fotherja/EV_Charger/README.md

# EV_Charger
Arduino Uno Code for EV Charger together with the design files etc

This project is documented in detail here: https://jamesfotherby.com/index-page/electric-vehicle-charger/
