fotherja/EV_Charger/EV Charger BOM.xlsx

EV Charger BOM
Description | Supplier | Part number | cost
Zappi Enclosure | 2nd hand off eBay... |  | £120
6mm2 SWA 5m length | https://quickbit.co.uk/ |  | £17.34
SWA Cable Gland Pack - CW20 Outdoor | https://quickbit.co.uk/swa-gland-pack-cw20/ |  | £5.34
SW Cleats | https://quickbit.co.uk/ |  | £1.99
50A MCB | Screwfix |  | £3.68
SMPS 340mA +/-15V | https://www.mouser.co.uk/ProductDetail/RECOM-Power/RAC10-15DK-277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 | RAC10-15DK/277 | £11.85
2 x 40A 250V relays | https://www.mouser.co.uk/ProductDetail/TE-Connectivity-PB/T9VV1K15-12S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 | T9VV1K15-12S | £18
LM317 | https://www.mouser.co.uk/ProductDetail/onsemi/lm317tg/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 | LM317TG | £0.67
LM337 | https://www.mouser.co.uk/ProductDetail/onsemi/lm337btg/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 | LM337BTG | £0.68
TVS 13.6V 600W bidirectional | https://www.mouser.co.uk/ProductDetail/Littelfuse/P6KE16CA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 | P6KE16CA | £0.35
Arduino Pro-Mini | https://www.amazon.co.uk/gp/product/B07VKLFYHY/ref=ppx_yo_dt_b_asin_title_o03_s00?ie=UTF8&psc=1 | . | £5.50
OP07 | https://www.mouser.co.uk/ProductDetail/Analog-Devices/OP07CPZ?qs=WIvQP4zGaninz564Y%252B7wyA%3D%3D | OP07CPZ | £2.25
LM358
GFCI Transformer with self test | https://shop.openenergymonitor.com/gfci-for-openevse/ | . | £32
All the other parts are more or less off the shelf...
