fotherja/EV_Charger/(threads)

Thread 1 (2022-04-29):

Not yet open source

MrTechGadget, 2022-04-29:
Can you select a license if you are intending this to be open source? Without a license, we can't use your materials even for private use or contribute to it.

Thanks, it looks great!

https://docs.github.com/en/repositories/managing-your-repositorys-settings-and-features/customizing-your-repository/licensing-a-repository

fotherja, 2022-04-29:
I have added an MIT license.txt file. Is that now ok or does that not work for the non-software files?

MrTechGadget, 2022-04-30:
Works perfectly and covers the Arduino code as well, thanks again for sharing this solution, I look forward to tinkering with my own!

Closed 2022-04-30.

Thread 2 (2022-05-17):

ADC operation

bosston88, 2022-05-17:
First, thanks for your work and for sharing it! I was looking at the code and found something I would like to understand better. Is ADC working in the way, that it reads Pilot voltage once and then GFCI value for 255 times? Then "selector" overflows and repeats?
`// This code runs when the PWM signal is in the middle of its low period
ISR(TIMER1_OVF_vect)
{
  static byte selector = 0;
  if(ADCSRA & 0b01000000)                                                       // If the ADC is still performing a conversion (it shouldn't be) then return
    return;

  if(selector && 1)  {
    ADMUX = B01000000;
    ADCSRA |= B01000000;
    ADC_Channel = 0;
  }
  else  {
    ADMUX = B01000001;
    ADCSRA |= B01000000;
    ADC_Channel = 1;
  }

  selector++;
}`
I think it violates the standard where you need to "react" to any change from state C within 100ms. Correct me if I'm wrong.

fotherja, 2022-05-17:
Hello,
Thanks for pointing this out. What I meant to do was a bitwise & so that as the selector variable increments it alternately reads the GFCI ADC channel and then the Pilot voltage before repeating

I suppose I never noticed because 255ms is still pretty quick. I will correct this.

bosston88, 2022-05-18:
Glad I could help. This could work:
`ISR(TIMER1_OVF_vect)
{
static byte selector = 0;
if(ADCSRA & 0b01000000) // If the ADC is still performing a conversion (it shouldn't be) then return
return;

if(selector) {
ADMUX = B01000000;
ADCSRA |= B01000000;
ADC_Channel = 0;
selector = 0;
}
else {
ADMUX = B01000001;
ADCSRA |= B01000000;
ADC_Channel = 1;
selector = 1;
}
}`

fotherja, 2022-05-22:
I have now corrected this and tested the new code. Up and running and working. Thank you very much!

Closed 2022-05-22.

Thread 3 (2023-03-22):

Cannot get car to charge

m1geo, 2023-03-22:
Hi.

I have copied your circuit part-for-part on your PCB and am having a few issues. Using resistors and a diode on the CP line, I can toggle between state A and state B, but cannot get into state C where charging begins.

If I connect my car (Tesla Model Y Perf) the car requests charging but the contactors never click. The car stops with "Ready to charge, waiting for charger power". The charger UART shows State A going into State B and stopping.

Just wondered where I should look first.

Thanks!

fotherja, 2023-03-23:
Sounds like the Arduino is not reading the pilot voltages correctly or the pilot voltages are not in spec.

If it moves from state A to state B then it must be reading the pilot voltage to some extent. Perhaps your resistor values aren't quite right?

I'd advise outputting the ADC readings over serial so that you can see whether they are appropriate. Let me know how it goes out of you have any other questions

m1geo, 2023-03-23:
Thanks. I thought as much. I'll tinker with the ADC threshold values - I saw your code for printing out the ADC values. Using that causes the Arduino to reboot, so I added a call to reset the WDT into the loop.

**Do you know what test resistor values I should be using to switch between each state?**

I'm using a simple 1N4148 in series with fixed through-hole resistors to simulate the car while testing. I see the same situation when using fixed resistors; State A > State B, but never any further. The Arduino ignores my attempt for a transition between State B onwards. Messing with the value too much results in a fault (understandable) but I cannot get things to work as I had hoped. I'm pretty sure I have used the correct resistors.

fotherja, 2023-03-23:
Good stuff re. Adding WDT reset into the loop.

In order to proceed from state B to state C the GFCI test needs to be successful. Is that holding things up?

A 900 ohm resistor and diode to ground should be about right.

m1geo, 2023-03-23:
Great, thanks. No, I have the RCD (GFCI) test working OK using a cheap transformer. I added 5 turns of wire to it to inject a fault current. Passes the test in around ~20ms (from my memory).

Nice project. Thanks.

Thread 5 (2023-03-24):

Adaption to 3-phase

m1geo, 2023-03-24:
Hi James.

Do you know what changes if I wish to make a 3-phase variant of this? My understanding is that I just provision 2 more relays and adjust the GFCI to monitor all phases?

Is the protocol is the same, with the PWM indicating the current per phase?

fotherja, 2023-03-27:
I'd only be guessing I'm afraid.

Closed 2023-03-27.

Thread 6 (2023-09-23):

Still working?

opb, 2023-09-23:
Hi James. I’ve been eying up your project for a while and even got some PCBs printed. I just wanted to double check that it’s all working as expected a year or more after it looks like this was completed. Any additional thoughts since the project was last updated?

Cheers,
Olly

fotherja, 2023-09-23:
Hi Olly,
I've been using the charger a few times a week since this repo was created. It's worked flawlessly. I think the last time I opened up the enclosure was over a year ago and that was to add the watch dog timer and fix a software bug that was identified early on. But the code here has those updates.

I've never hankered after any smart features because I can set charge times using my car's phone app and my electricity is monitored by my smart meter anyway.

I can't say that all my projects have proven to be as reliable as this one. It worked through last year's scorching summer and this winters -10oC nights. So I'm genuinely very pleased with it.

I have noticed on the pilot pin of the charging plug a very small amount of blue (I guess copper) corrosion. It's barely noticeable even after a year and I don't think it'll ever cause a problem. plugging/unplugging keeps the contacts clean. I was wondering if this could be because 12v DC is on the pilot pin continuously. I'm not going to do anything about it - since I noticed it I always hang the charging plug down so water will never pool inside the plug (it's all outside). If I had to think of an improvement on this project I'd look into making (hardware and software changes) so that in the idle state, the hardware only occasionally applies 12v to the pilot pin to see whether a car is connected and if not keeps the pilot pin at 0v. If that makes sense?

opb, 2023-09-23:
Hi James

Thanks for the response. Great to hear it’s still working flawlessly! I was contemplating making a a couple of adjustments to get a networked Arduino in there, and have it communicate state or error state to Home Assistant. However, I have a networked 40A relay with power monitoring that I’ll put into the enclosure for turning overall power on or off. I think trying to modify the code and PCB would just mean I’ll never get it completed!

Plus, if there is an issue with the 12v pulse running constantly, hopefully that would be resolved with the ability to turn on and off to a schedule with Home Assistant. Sadly my car has no app or any smart features.

Last question, sorry - how does the PWM value of 350 translate to the 30-32A needed for the 7.4kW you mention in the code comments? The linked docs in your PDF indicate a 50-55% duty cycle for this current, so I’m keen to understand how the value in the code maps to the percentage. If you have any insight, it would be much appreciated!

Thanks

fotherja, 2023-09-25:
Hi Olly,
Regarding the PWM value of 350. Good point. This was trial and error for me. I tried a few values and this resulted in a 7.4kW charge rate. Can't really say how it translates although when I scoped the PWM signal being generated there is quite a noticeable skew rate from the op-amp output. Perhaps this is why it doesn't translate accurately. A faster op-amp might help this. I've never charged any other car than my Kia ENiro so I don't know if different cars would read the PWM signal differently because of the slew and charge at slightly different rates.

opb, 2023-10-10:
Hi James. I'll close this issue. I now have a fully built PCB and am looking forward to final assembly. I do have one question, which I'll open as a separate issue.

Thanks again for your work on this project!

Closed 2023-10-10.

Thread 7 (2023-10-07):

Discussion: a tutorial maybe?

vahidreza, 2023-10-07:
hi @fotherja,
great experiment btw, i happen to do the same thing with pico as a trial to see if i can make my own complete product out of it.
do you consider putting up a course about it? maybe on udemy or similar? that would be a killer i think and im gonna buy right in to it! :)

fotherja, 2023-10-11:
It's a good idea. I have documented the build fairly thoroughly on my website (https://jamesfotherby.com/index-page/electric-vehicle-charger/)

I could make a full course - although I don't know how responsible this would be of me. This project doesn't comply with the stringent safety requirements of modern EV chargers (Type B RCD functionality etc). People need to build this at their own risk and take responsibility of its safety themselves - I don't want to take on any of that responsibility!

Thread 8 (2023-10-10):

GFCI test successful with no hardware

opb, 2023-10-10:
Hi James

I've flashed the pro mini and with no other hardware connected, just the mini connected via the serial-USB dongle, I get the following on the serial monitor:

```Ground fault detection time: 19 ms
GFCI Test Successful
Starting in State A
FAULT: 5```

I guess fault `5` is to be expected - no pilot voltage, but I wouldn't have expected it to pass the GFCI test. Would you expect it to do this if detached from the board?

Thanks

fotherja, 2023-10-10:
Hi,
Interesting. Without the current transformer attached the GFCI test should not pass. I suspect a hardware problem. Can you use a multimeter to measure the voltage on A0 which is the processed GFCI signal. It should be 0v. Are you happy with the op-amps and their connections etc?

fotherja, 2023-10-11:
Also, you shouldn't be getting a fault 5 code. I suspect you're getting this code because the pilot should be DC +12v but this isn't being produced accurately enough by the op-amps.

The op-amps can't necessarily swing their outputs to their supply rails. As such they need suppling with a slightly higher voltage than what you want them to produce. I think my power rails are +/- 13.5V. Use a multimeter to measure your +12V DC pilot signal and adjust your +ve power supply voltage until you get this. (I'd then set the -ve rail voltage to be equal in magnitude to the +ve rail)
