fotherja/EV_Charger/KiCad_Files/EV_Charger2.kicad_pcb

## KiCad design KiCad_Files/EV_Charger2.kicad_pcb (2022-04-20)

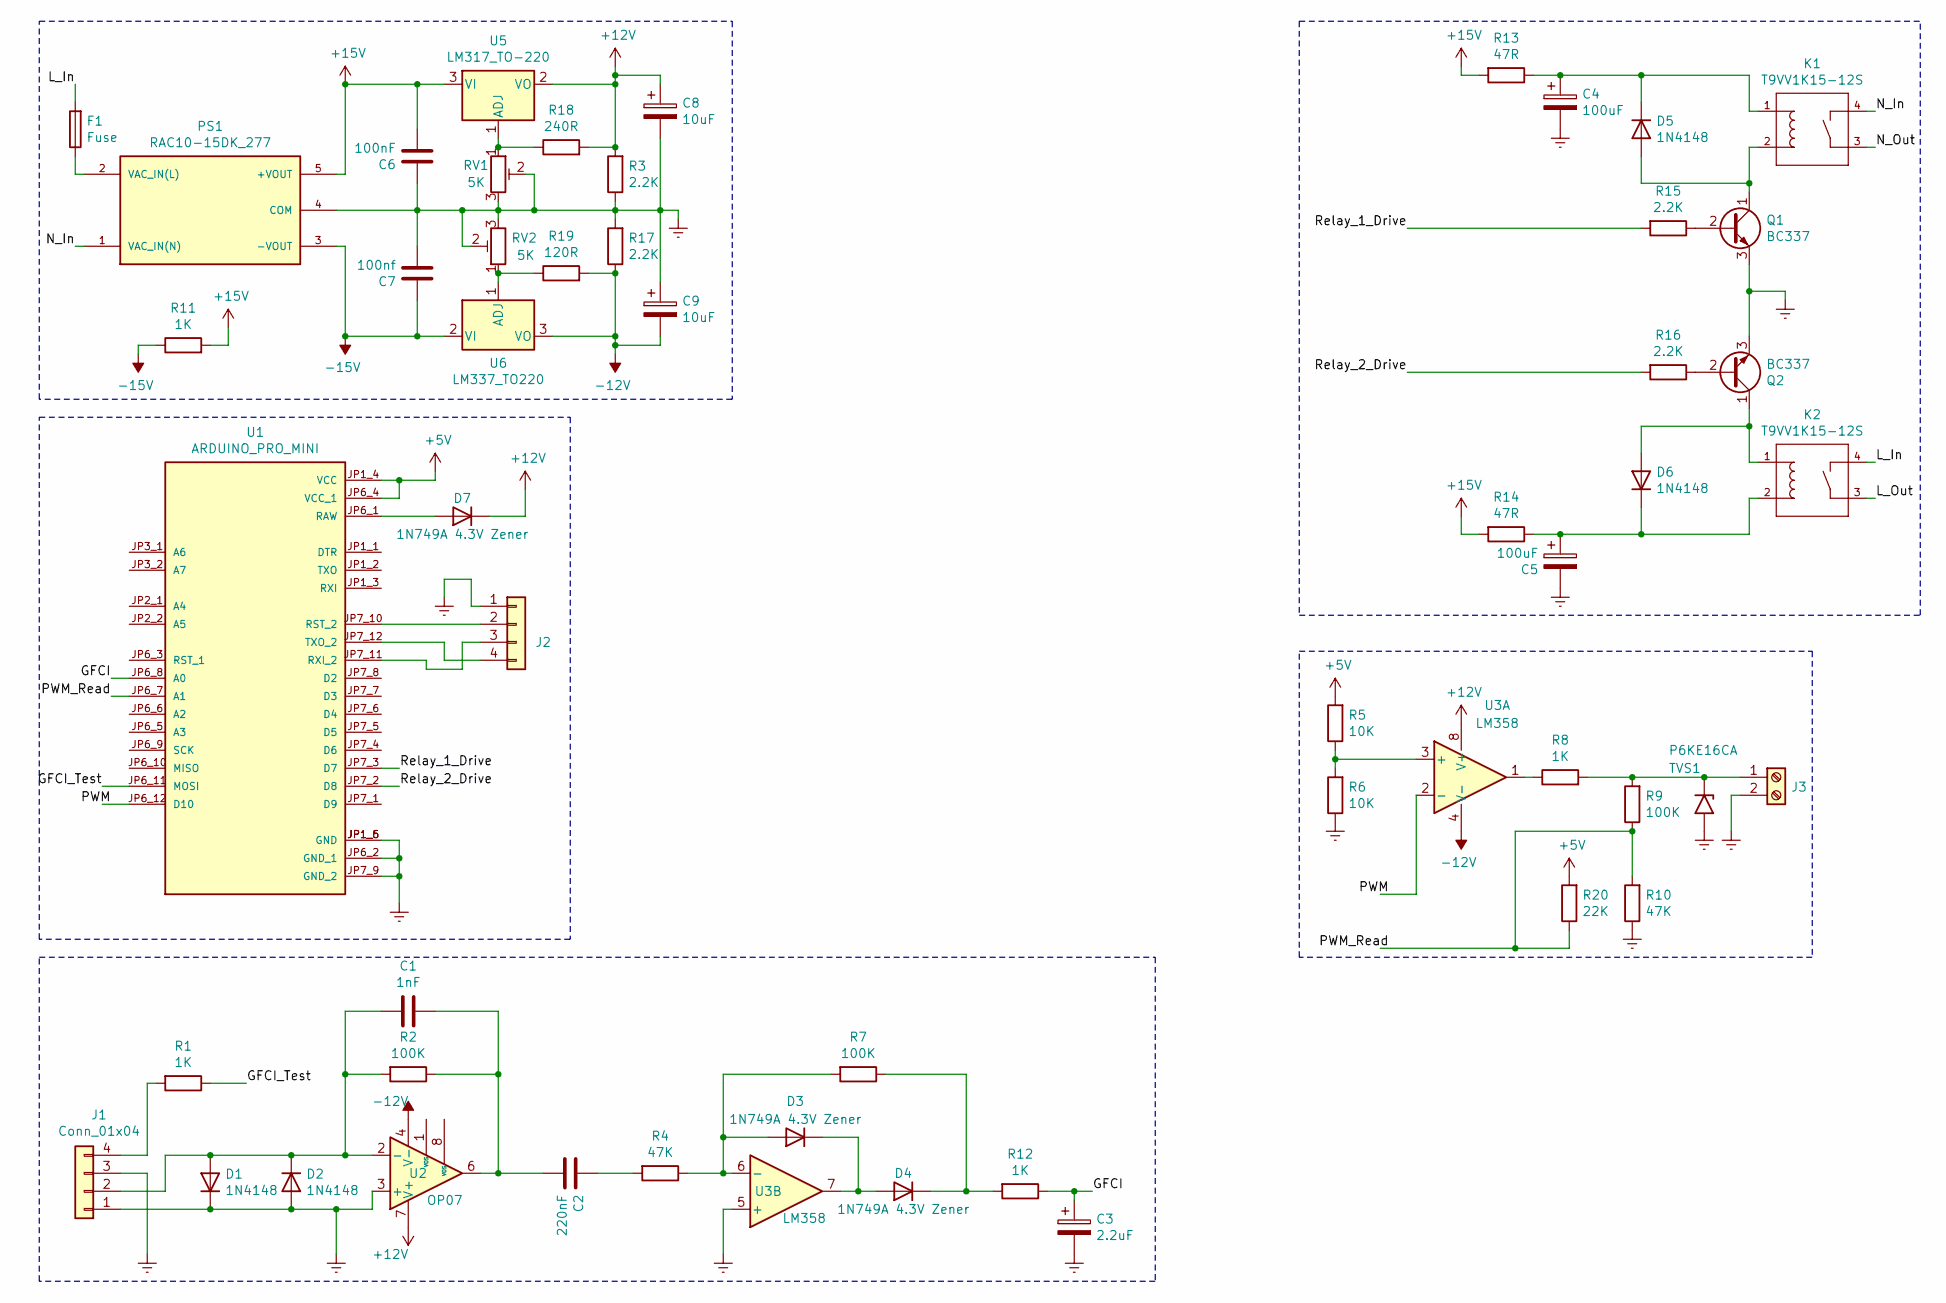
[picture p15: schematic EV_Charger2.sch, EV Charger Schematic]

Parts:
C1: 1nF; C_Disc_D3.4mm_W2.1mm_P2.50mm
C2: 220nF; C_Disc_D3.4mm_W2.1mm_P2.50mm
C3: 2.2uF; CP_Radial_D4.0mm_P1.50mm
C4, C5: 100uF; CP_Radial_D5.0mm_P2.50mm
C6: 100nF; C_Disc_D3.4mm_W2.1mm_P2.50mm
C7: 100nf; C_Disc_D3.4mm_W2.1mm_P2.50mm
C8, C9: 10uF; CP_Radial_D5.0mm_P2.50mm
D1, D2, D5, D6: 1N4148; D_DO-35_SOD27_P7.62mm_Horizontal
D3, D4, D7: 1N749A 4.3V Zener; D_DO-35_SOD27_P7.62mm_Horizontal
F1: Fuse; Fuseholder5x20_horiz_open_lateral_Type-II
J1, J2: Conn_01x04; Pin_Header_Straight_1x04_Pitch2.54mm
J3: Screw_Terminal_01x02; Socket_Strip_Straight_1x02_Pitch2.54mm
K1, K2: T9VV1K15-12S; RELAY_T9VV1K15-12S
PS1: RAC10-15DK_277; CONV_RAC10-15DK_277; PARTREV 8/2020
Q1, Q2: BC337; TO-92_Molded_Narrow
R1, R8, R12: 1K; R_Axial_DIN0207_L6.3mm_D2.5mm_P10.16mm_Horizontal
R2, R7, R9: 100K; R_Axial_DIN0207_L6.3mm_D2.5mm_P10.16mm_Horizontal
R3, R15, R16, R17: 2.2K; R_Axial_DIN0207_L6.3mm_D2.5mm_P10.16mm_Horizontal
R4, R10: 47K; R_Axial_DIN0207_L6.3mm_D2.5mm_P10.16mm_Horizontal
R5, R6: 10K; R_Axial_DIN0207_L6.3mm_D2.5mm_P10.16mm_Horizontal
R11: 1K; R_Axial_DIN0309_L9.0mm_D3.2mm_P15.24mm_Horizontal
R13, R14: 47R; R_Axial_DIN0309_L9.0mm_D3.2mm_P15.24mm_Horizontal
R18: 240R; R_Axial_DIN0207_L6.3mm_D2.5mm_P10.16mm_Horizontal
R19: 120R; R_Axial_DIN0207_L6.3mm_D2.5mm_P10.16mm_Horizontal
R20: 22K; R_Axial_DIN0207_L6.3mm_D2.5mm_P10.16mm_Horizontal
RV1, RV2: 5K; Potentiometer_Trimmer_Bourns_PV36W
TVS1: P6KE16CA; D_DO-35_SOD27_P10.16mm_Horizontal
U1: ARDUINO_PRO_MINI; MODULE_ARDUINO_PRO_MINI; PARTREV N/A
U2: OP07; DIP-8_W7.62mm
U3: LM358; DIP794W45P254L959H508Q8
U5: LM317_TO-220; TO-220-3_Vertical
U6: LM337_TO220; TO-220-3_Vertical

Connections:
+5V: R5.2, R20.2, U1.JP1_4 (VCC), U1.JP6_4 (VCC_1)
+12V: C8.1, D7.1 (K), R3.2, R18.2, U2.7 (V+), U3.8 (V+), U5.2 (VO)
+15V: C6.2, PS1.5 (+VOUT), R11.2, R13.2, R14.2, U5.3 (VI)
-12V: C9.2, R17.1, R19.2, U2.4 (V-), U3.4 (V-), U6.3 (VO)
-15V: C7.1, PS1.3 (-VOUT), R11.1, U6.2 (VI)
/GFCI: C3.1, R12.1, U1.JP6_8 (A0)
/GFCI_Test: R1.1, U1.JP6_11 (MOSI)
/L_In: F1.2, K2.4; also elsewhere on the board
/L_Out: K2.3; also elsewhere on the board
/N_In: K1.4, PS1.1 (VAC_IN(N)); also elsewhere on the board
/N_Out: K1.3; also elsewhere on the board
/PWM: U1.JP6_12 (D10), U3.2 (-)
/PWM_Read: R9.1, R10.2, R20.1, U1.JP6_7 (A1)
/Relay_1_Drive: R15.2, U1.JP7_3 (D7)
/Relay_2_Drive: R16.2, U1.JP7_2 (D8)
Earth: C3.2, C4.2, C5.2, C6.1, C7.2, C8.2, C9.1, D1.1 (K), D2.2 (A), J1.1, J1.3, J2.1, J3.2, PS1.4 (COM), Q1.3 (E), Q2.3 (E), R3.1, R6.1, R10.1, R17.2, RV1.2, RV1.3, RV2.2, RV2.3, TVS1.2 (A2), U1.JP1_5 (GND), U1.JP1_6 (GND), U1.JP6_2 (GND_1), U1.JP7_9 (GND_2), U2.3 (+), U3.5 (+); also elsewhere on the board
unnamed: C1.1, C2.2, R2.1, U2.6
unnamed: C1.2, D1.2 (A), D2.1 (K), J1.2, R2.2, U2.2 (-)
unnamed: C2.1, R4.2
unnamed: C4.1, D5.1 (K), K1.1, R13.1
unnamed: C5.1, D6.1 (K), K2.2, R14.1
unnamed: D3.1 (K), D4.2 (A), U3.7
unnamed: D3.2 (A), R4.1, R7.2, U3.6 (-)
unnamed: D4.1 (K), R7.1, R12.2
unnamed: D5.2 (A), K1.2, Q1.1 (C)
unnamed: D6.2 (A), K2.1, Q2.1 (C)
unnamed: D7.2 (A), U1.JP6_1 (RAW)
unnamed: F1.1, PS1.2 (VAC_IN(L))
unnamed: J1.4, R1.2
unnamed: J2.2, U1.JP7_10 (RST_2)
unnamed: J2.3, U1.JP7_11 (RXI_2)
unnamed: J2.4, U1.JP7_12 (TXO_2)
unnamed: J3.1, R8.2, R9.2, TVS1.1 (A1)
unnamed: Q1.2 (B), R15.1
unnamed: Q2.2 (B), R16.1
unnamed: R5.1, R6.2, U3.3 (+)
unnamed: R8.1, U3.1
unnamed: R18.1, RV1.1, U5.1 (ADJ)
unnamed: R19.1, RV2.1, U6.1 (ADJ)

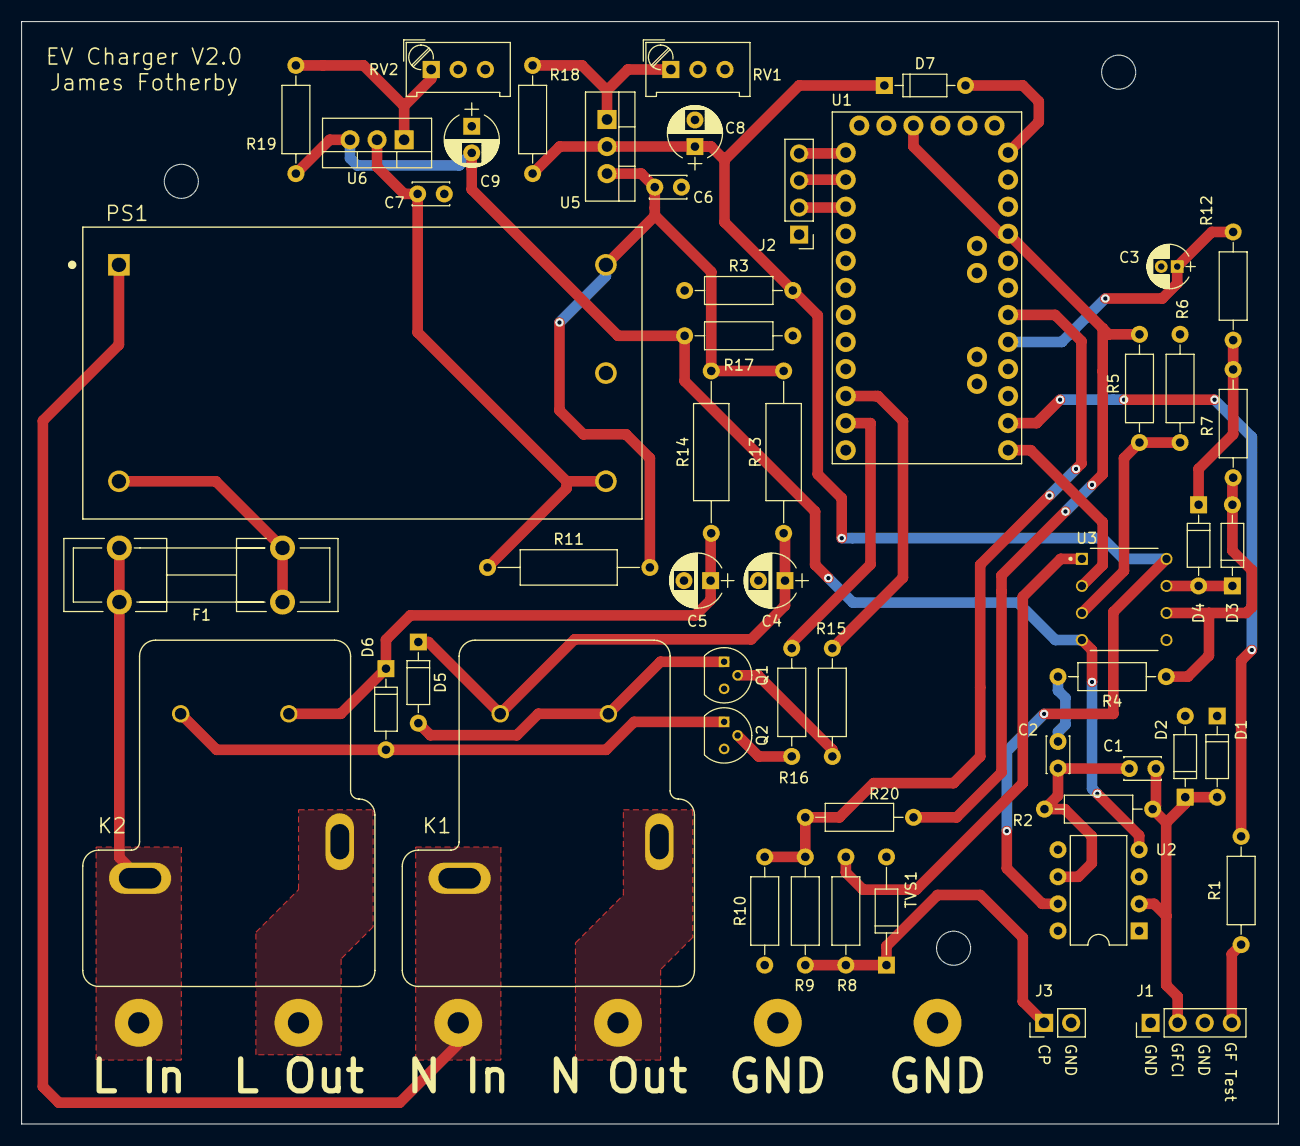
[picture p16: board EV_Charger2.kicad_pcb from above]

Board: 2 copper layers, 118.0 x 103.5 mm, 59 parts (0 on the bottom side), 39 nets.

Other parts of the board:
GND: SolderWirePad_single_2mmDrill
GND#2: SolderWirePad_single_2mmDrill
L In: SolderWirePad_single_2mmDrill
L Out: SolderWirePad_single_2mmDrill
N In: SolderWirePad_single_2mmDrill
N Out: SolderWirePad_single_2mmDrill

Their connections:
/L_In: L In.1; also elsewhere on the board
/L_Out: L Out.1; also elsewhere on the board
/N_In: N In.1; also elsewhere on the board
/N_Out: N Out.1; also elsewhere on the board
Earth: GND.1, GND#2.1; also elsewhere on the board
