fotherja/EV_Charger/(commit log)

2022-04-19 Working 1st Upload
    - Needs better fault management - current code simply makes the unit safe and goes into and infinite while loop
2022-05-22 WDT and bug fix
    Added WDT
    Fixed a bug identified by bosston88 in the Timer interrupts where the ADC channel wasn't being alternated properly
    Changed required successive trivial faults from 100 to 10
    [EV_Charger.ino]
2024-01-11 Reduced GFCI sensitivity
    A Zoe ZE50 was occasionally tripping out the GFCI. I think it was set too sensitive so I have increased the ADC threshold for a trip
    It now takes around 40ms to detect a 25mA ground current which is still fine.
    All working well otherwise and has been in constant use for the past couple years
